mjeanrichard/LoraSensor/Firmware/LoraSensor/README.md

Topic devices/OMG_LILYGO/commands/MQTTtoLORA

{"message":"{\"id\":\"f0f5bdc19400\",\"name\":\"kiwi\",\"test\":false}"}

devices/OMG_LILYGO/LORAtoMQTT/3c84279d2150
