mjeanrichard/LoraSensor/Box/Box.FCStd

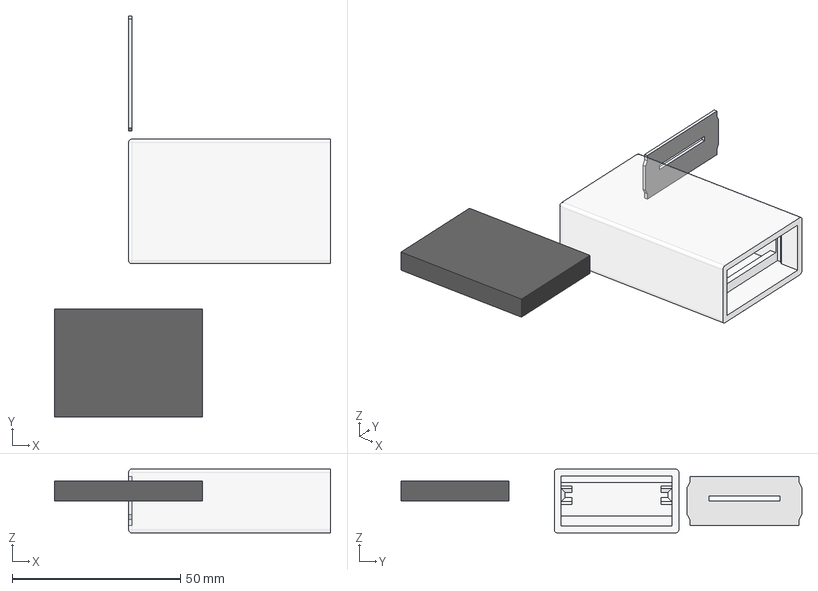
[picture p1: CAD file, 2024-07-07]
Box/Box.FCStd
82.0 x 119.1 x 19.0 mm
BatteryBody
LidBody
