mjeanrichard/LoraSensor/Box/Pcb.FCStd

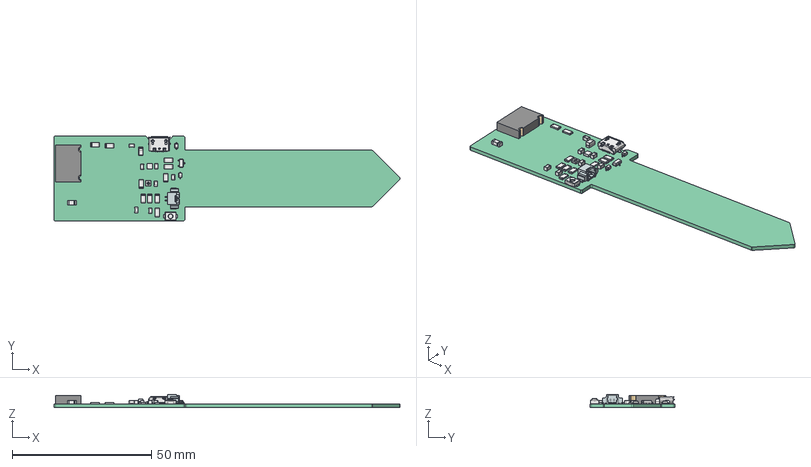
[picture p2: CAD file, 2024-07-07]
Box/Pcb.FCStd
124.2 x 30.5 x 4.69 mm
Pcb_7a2a
R10_R_1206_3216Metric_2f96db2df0e" x 10
C8_C_0805_2012Metric_733a677ac18" x 7
C3_CP_EIA_3216_18_Kemet_A_c737fdafe5b"
U1_WSON_6_1EP_2x2mm_P065mm_EP1x16mm_d4f6cbaf017"
D1_D_SOD_323_4d344dbe9df" x 2
J2_USB_Micro-B_Molex_47346-0001_fa0011b9db4"
J1_532614002wbm000_01_76511110587"
SW1_3x4x2mm - 2 button_fc822de3670"
ANT-433-USP410
ANT-433-USP411
ANT-433-USP412
SHTC1
SHTC002
SHTC003
SHTC004
SHTC005
SHTC006
SHTC007
SHTC008
SHTC009
SHTC010
Q1_SOT_23_b06cfdb17f5"
