mjeanrichard/LoraSensor/Board/LoraSensor/Symbols/ANT-868-USP410.STEP

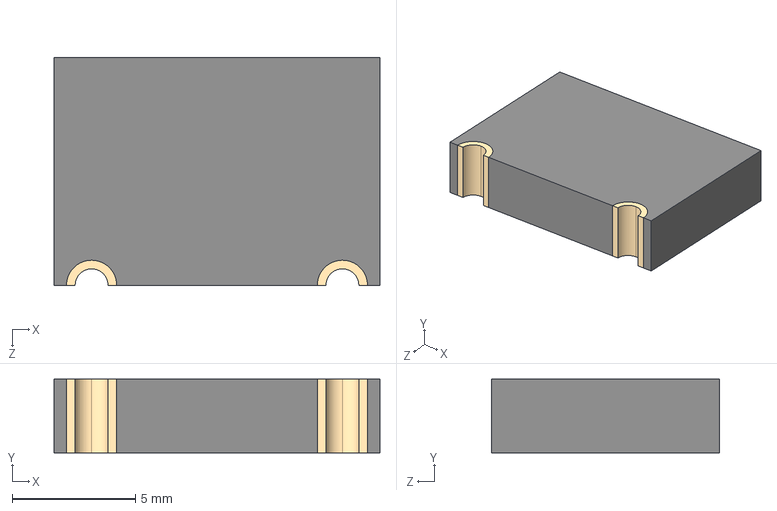
[picture p3: CAD file, 2024-06-06]
Board/LoraSensor/Symbols/ANT-868-USP410.STEP
13.2 x 3.00 x 9.22 mm
