mjeanrichard/LoraSensor/Board/LoraSensor/Symbols/2450AT18A100E_JOT.step

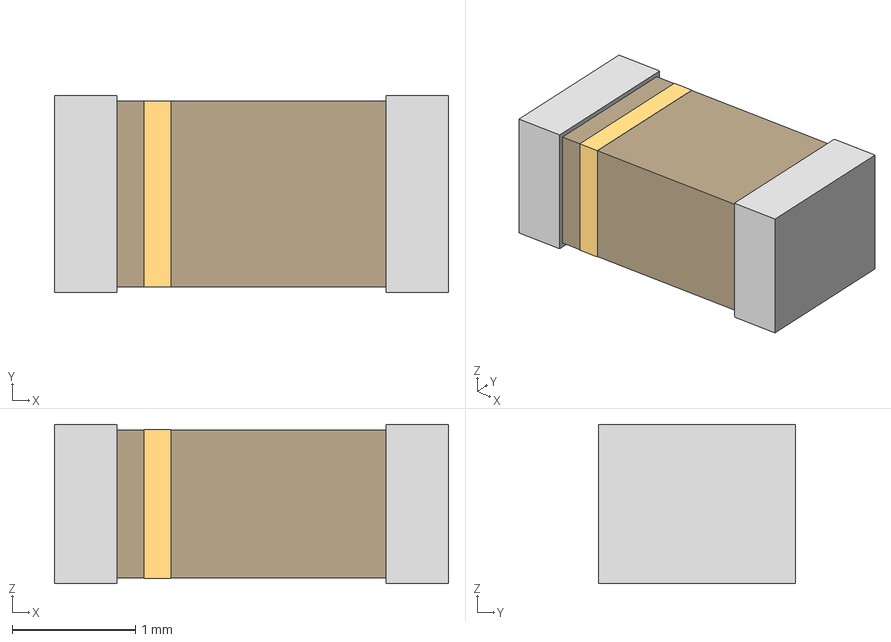
[picture p4: CAD file, 2024-06-06]
Board/LoraSensor/Symbols/2450AT18A100E_JOT.step
3.20 x 1.60 x 1.29 mm
