mjeanrichard/LoraSensor/Box/Box-Body.step

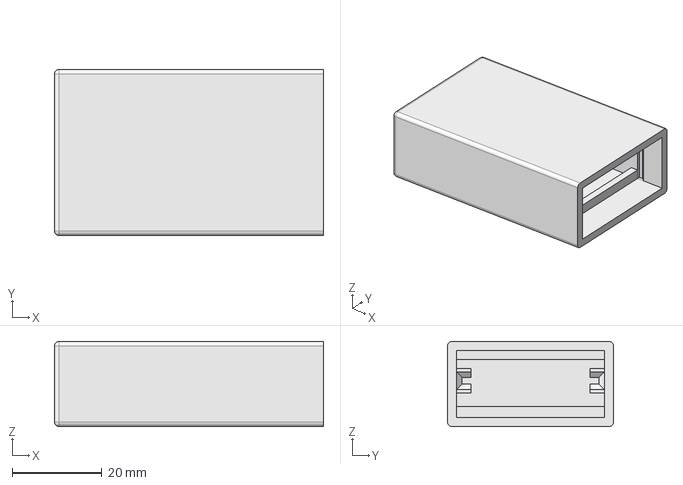
[picture p5: CAD file, 2024-07-07]
Box/Box-Body.step
60.0 x 37.0 x 19.0 mm
