mjeanrichard/LoraSensor/Board/LoraSensor/Symbols/HT_CD_SHTC3_STEP_File_V1_D1.STEP

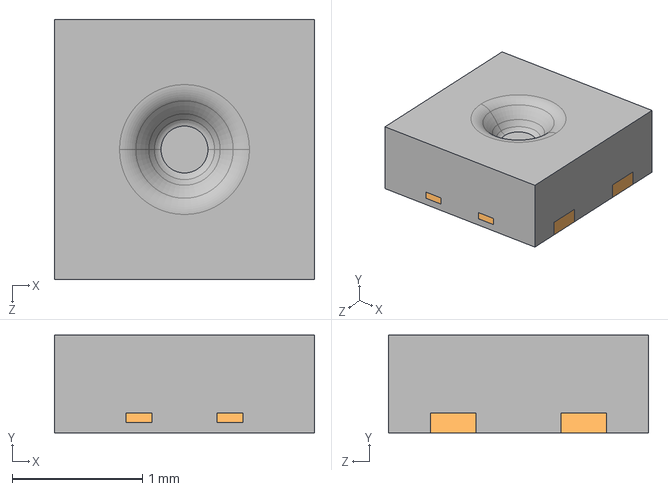
[picture p6: CAD file, 2024-06-06]
Board/LoraSensor/Symbols/HT_CD_SHTC3_STEP_File_V1_D1.STEP
2.00 x 0.75 x 2.00 mm
