mjeanrichard/LoraSensor/Board/LoraSensor/Symbols/532614002.stp

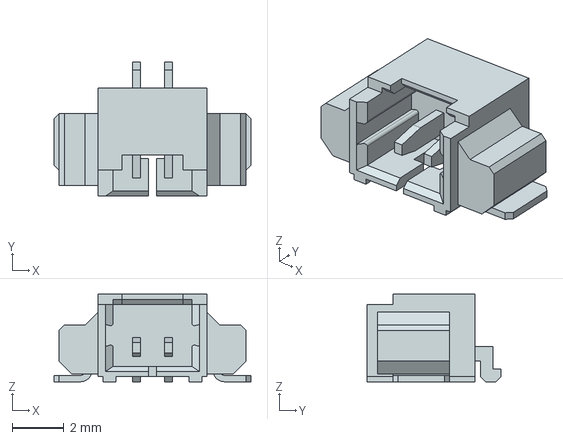
[picture p7: CAD file, 2024-06-06]
Board/LoraSensor/Symbols/532614002.stp
7.65 x 5.20 x 3.40 mm
