mjeanrichard/LoraSensor/Board/LoraSensor/Symbols/532614003.stp

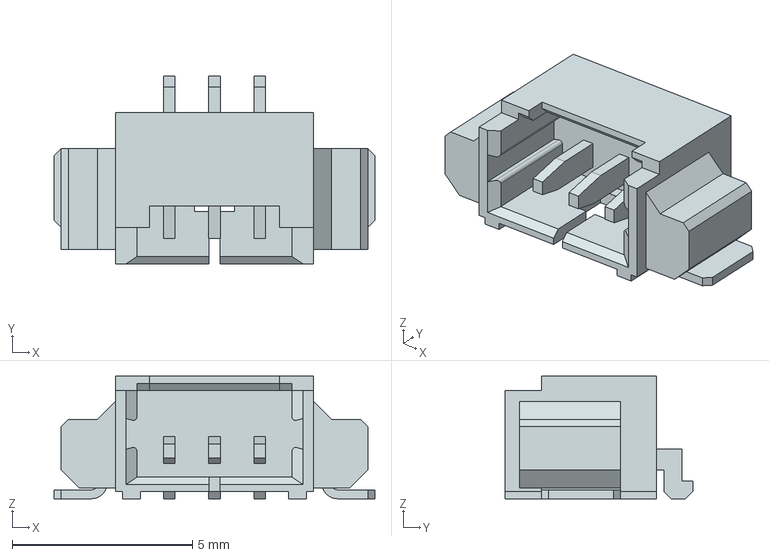
[picture p8: CAD file, 2024-06-06]
Board/LoraSensor/Symbols/532614003.stp
8.90 x 5.20 x 3.40 mm
