mjeanrichard/LoraSensor/(list of files, cad)

Other CAD files:
Box/BoxAssembly.FCStd
