mjeanrichard/LoraSensor/Board/LoraSensor/LoraSensor.kicad_pcb

## KiCad design Board/LoraSensor/LoraSensor.kicad_pcb (2024-07-07)

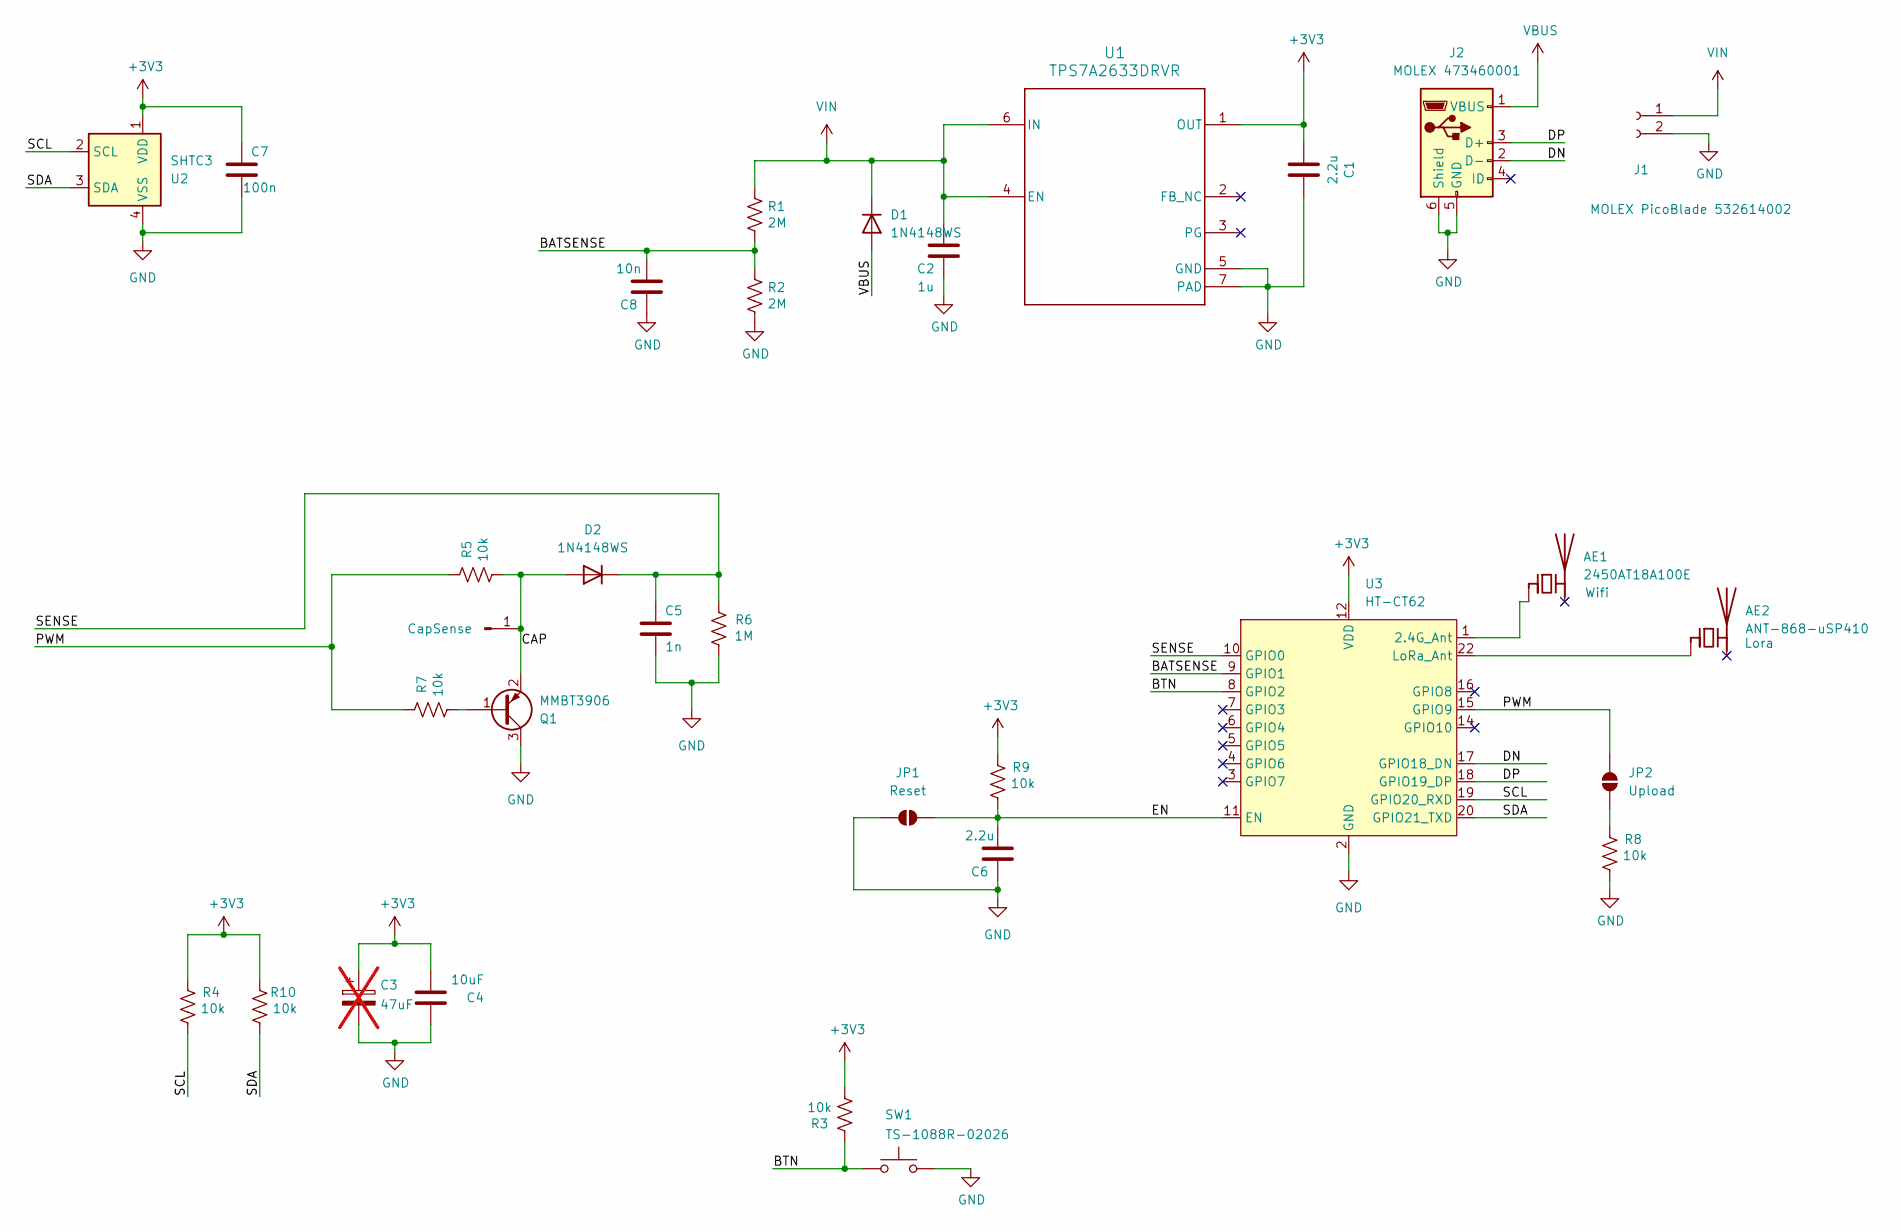
[picture p9: schematic LoraSensor.kicad_sch]

Parts:
AE1: 2450AT18A100E; 2450AT18A100E_JOT
AE2: ANT-868-uSP410
C1, C6: 2.2u; C_0805_2012Metric_Pad1.18x1.45mm_HandSolder
C2: 1u; C_0805_2012Metric_Pad1.18x1.45mm_HandSolder
C3: 47uF; CP_EIA-3216-18_Kemet-A_Pad1.58x1.35mm_HandSolder; not fitted
C4: 10uF; C_0805_2012Metric_Pad1.18x1.45mm_HandSolder
C5: 1n; C_0805_2012Metric_Pad1.18x1.45mm_HandSolder
C7: 100n; C_0805_2012Metric_Pad1.18x1.45mm_HandSolder
C8: 10n; C_0805_2012Metric_Pad1.18x1.45mm_HandSolder
D1, D2: 1N4148WS; D_SOD-323
J1: MOLEX PicoBlade 532614002; 532614002
J2: MOLEX 473460001; USB_Micro-B_Molex_47346-0001
J4: CapSense
JP1: Reset; SolderJumper-2_P1.3mm_Open_RoundedPad1.0x1.5mm
JP2: Upload; SolderJumper-2_P1.3mm_Open_RoundedPad1.0x1.5mm
Q1: MMBT3906; SOT-23
R1, R2: 2M; R_1206_3216Metric
R3, R4, R5, R7, R8, R9, R10: 10k; R_1206_3216Metric
R6: 1M; R_1206_3216Metric
SW1: TS-1088R-02026; smd-tactile
U1: TPS7A2633DRVR; TI_WSON-6-1EP_2x2mm_P0.65mm_EP1x1.6mm
U2: SHTC3; Sensirion_DFN-4-1EP_2x2mm_P1mm_EP0.7x1.6mm
U3: HT-CT62; Heltec_HT-CT62

Connections:
+3V3: C1.2, C3.1, C4.2, C7.1, R3.2, R4.2, R9.2, R10.2, U1.1 (OUT), U2.1 (VDD), U3.12 (VDD)
/BATSENSE: C8.2, R1.2, R2.2, U3.9 (GPIO1)
/BTN: R3.1, SW1.1, U3.8 (GPIO2)
/CAP: D2.2 (A), J4.1, Q1.2 (E), R5.2
/DN: J2.2 (D-), U3.17 (GPIO18_DN)
/DP: J2.3 (D+), U3.18 (GPIO19_DP)
/EN: C6.2, JP1.2 (B), R9.1, U3.11 (EN)
/PWM: JP2.2 (B), R5.1, R7.1, U3.15 (GPIO9)
/SCL: R4.1, U2.2 (SCL), U3.19 (GPIO20_RXD)
/SDA: R10.1, U2.3 (SDA), U3.20 (GPIO21_TXD)
/SENSE: C5.1, D2.1 (K), R6.1, U3.10 (GPIO0)
GND: C1.1, C2.1, C3.2, C4.1, C5.2, C6.1, C7.2, C8.1, J1.2, J2.5 (GND), J2.6 (Shield), JP1.1 (A), Q1.3 (C), R2.1, R6.2, R8.1, SW1.2, U1.5 (GND), U1.7 (PAD), U2.4 (VSS), U3.2 (GND), U3.13 (GND), U3.21 (GND)
unnamed: AE1.1 (FEED), U3.1 (2.4G_Ant)
unnamed: AE2.1 (FEED), U3.22 (LoRa_Ant)
unnamed: JP2.1 (A), R8.2
unnamed: Q1.1 (B), R7.2
VBUS: D1.2 (A), J2.1 (VBUS)
VIN: C2.2, D1.1 (K), J1.1, R1.1, U1.4 (EN), U1.6 (IN)

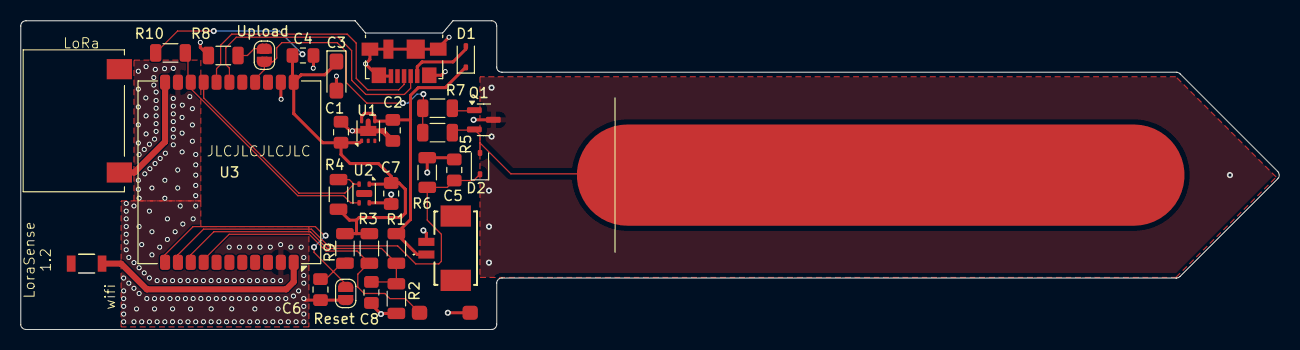
[picture p10: board LoraSensor.kicad_pcb from above]

Board: 2 copper layers, 124.2 x 30.5 mm, 32 parts (0 on the bottom side), 18 nets.
