mjeanrichard/LoraSensor/Firmware/LoraSensor/main/config.h

#pragma once

#include "driver/gpio.h"

#define PIN_SDA GPIO_NUM_21
#define PIN_SCL GPIO_NUM_20
#define PIN_SOIL_SENSE GPIO_NUM_0
#define PIN_SOIL_PWM GPIO_NUM_9
#define PIN_BAT GPIO_NUM_1
#define PIN_BTN GPIO_NUM_2
#define BATTERY_ADC_CHANNEL ADC_CHANNEL_1
#define MOISTURE_ADC_CHANNEL ADC_CHANNEL_0

#define PIN_RADIO_DIO1 GPIO_NUM_3
#define PIN_RADIO_BUSY GPIO_NUM_4
#define PIN_RADIO_RST GPIO_NUM_5
#define PIN_RADIO_MISO GPIO_NUM_6
#define PIN_RADIO_MOSI GPIO_NUM_7
#define PIN_RADIO_NSS GPIO_NUM_8
#define PIN_RADIO_SCK GPIO_NUM_10

#define PWM_FREQ 500000
#define NUM_ADC_READS 5

// %s is replaced by the version string (e.g. "1.1")
#define OTA_FIRMWARE_URL_TEMPLATE "https://github.com/mjeanrichard/LoraSensor/releases/download/v%s/LoraSensor.bin"

#define LORA_FREQ_MHZ   868.0
#define LORA_BW_KHZ     125.0
#define LORA_SF         7
#define LORA_CR         5
#define LORA_SYNC_WORD  0x12
#define LORA_PREAMBLE   8
