mjeanrichard/LoraSensor/Firmware/LoraSensor/main/settings.cpp

#include "settings.h"

static const char *TAG = "SETTINGS";
static const char *NVS_NAMESPACE = "settings";

esp_err_t Settings::save()
{
    nvs_handle_t nvs;

    ESP_RETURN_ON_ERROR(nvs_open(NVS_NAMESPACE, NVS_READWRITE, &nvs), TAG, "Could not open nvs in write mode.");
    ESP_RETURN_ON_ERROR(nvs_set_str(nvs, "name", _name.c_str()), TAG, "Could not write name to nvs.");
    ESP_RETURN_ON_ERROR(nvs_set_i8(nvs, "isTest", _isTest), TAG, "Could not write isTest to nvs.");
    ESP_RETURN_ON_ERROR(nvs_set_u16(nvs, "sleep", _sleepSeconds), TAG, "Could not write sleep to nvs.");
    ESP_RETURN_ON_ERROR(nvs_set_u8(nvs, "wait", _waitSeconds), TAG, "Could not write wait to nvs.");
    ESP_RETURN_ON_ERROR(nvs_set_u8(nvs, "pwr", _transmitPower), TAG, "Could not write pwr to nvs.");
    ESP_RETURN_ON_ERROR(nvs_set_u8(nvs, "retx", _retransmits), TAG, "Could not write retx to nvs.");
    ESP_RETURN_ON_ERROR(nvs_set_u16(nvs, "moiDry", _moiDry), TAG, "Could not write moiDry to nvs.");
    ESP_RETURN_ON_ERROR(nvs_set_u16(nvs, "moiWet", _moiWet), TAG, "Could not write moiWet to nvs.");
    ESP_RETURN_ON_ERROR(nvs_set_str(nvs, "ssid", _ssid.c_str()), TAG, "Could not write ssid to nvs.");
    ESP_RETURN_ON_ERROR(nvs_set_str(nvs, "wifiPwd", _wifiPwd.c_str()), TAG, "Could not write wifiPwd to nvs.");
    ESP_RETURN_ON_ERROR(nvs_set_u16(nvs, "v", ++_configVersion), TAG, "Could not write v to nvs.");
    ESP_RETURN_ON_ERROR(nvs_commit(nvs), TAG, "Could not commit nvs.");
    nvs_close(nvs);

    return ESP_OK;
}

esp_err_t Settings::load()
{
    nvs_handle_t nvs;
    esp_err_t ret = nvs_open(NVS_NAMESPACE, NVS_READONLY, &nvs);
    if (ret == ESP_ERR_NVS_NOT_FOUND)
    {
        _name = "Test";
        save();
        ret = nvs_open(NVS_NAMESPACE, NVS_READONLY, &nvs);
        if (ret != ESP_OK)
        {
            ESP_LOGE(TAG, "Could not open NVS in read mode (%i).", ret);
            return ret;
        }
    }
    else if (ret != ESP_OK)
    {
        ESP_LOGE(TAG, "Failed to open NVS settings (%i).", ret);
        return ret;
    }

    esp_err_t err = ESP_OK;
    if (err == ESP_OK) err = readString(nvs, "name", _name);
    if (err == ESP_OK) err = readBool(nvs, "isTest", &_isTest);
    if (err == ESP_OK) err = nvs_get_u16(nvs, "sleep", &_sleepSeconds);
    if (err == ESP_OK) err = nvs_get_u8(nvs, "wait", &_waitSeconds);
    if (err == ESP_OK) err = nvs_get_u8(nvs, "pwr", &_transmitPower);
    if (err == ESP_OK) err = nvs_get_u8(nvs, "retx", &_retransmits);
    if (err == ESP_OK) err = nvs_get_u16(nvs, "v", &_configVersion);

    // optional keys added in later firmware; keep defaults if absent
    uint16_t tmp;
    if (nvs_get_u16(nvs, "moiDry", &tmp) == ESP_OK) _moiDry = tmp;
    if (nvs_get_u16(nvs, "moiWet", &tmp) == ESP_OK) _moiWet = tmp;
    std::string tmpStr;
    if (readString(nvs, "ssid", tmpStr) == ESP_OK) _ssid = tmpStr;
    if (readString(nvs, "wifiPwd", tmpStr) == ESP_OK) _wifiPwd = tmpStr;

    nvs_close(nvs);
    return err;
}

esp_err_t Settings::readString(nvs_handle_t nvs, const char *key, std::string &field)
{
    size_t len = 0;
    ESP_RETURN_ON_ERROR(nvs_get_str(nvs, key, nullptr, &len), TAG, "Could not get length of '%s' from NVS.", key);
    char buffer[len];
    ESP_RETURN_ON_ERROR(nvs_get_str(nvs, key, buffer, &len), TAG, "Could not get value of '%s' from NVS.", key);
    field.assign(buffer);
    return ESP_OK;
}

esp_err_t Settings::readBool(nvs_handle_t nvs, const char *key, bool *value)
{
    int8_t isTest = false;
    RETURN_ON_ERROR(nvs_get_i8(nvs, key, &isTest));
    *value = isTest;
    return ESP_OK;
}
