mjeanrichard/LoraSensor/(commit log)

2024-06-06 Initial Firmware
    [2450AT18A100E_JOT.step, 532614002.stp, 532614003.stp, ANT-868-USP410.STEP, HT_CD_SHTC3_STEP_File_V1_D1.STEP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]
2024-06-20 PCB V1.1
    [Box.FCStd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]
2024-06-26 Version 1.1
    [Box-Body.step, Box.FCStd, LoraSensor.kicad_pcb, LoraSensor.kicad_sch]
2024-07-07 PCB Version 1.2
    [Box-Body.step, Box.FCStd, BoxAssembly.FCStd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]
2026-06-20 fix add firmware version
    [LoraClient.cpp, adc.cpp, adc.h, config.h, main.cpp, settings.cpp, settings.h]
2026-06-22 fix: first wifi implementation
    [partitions.csv]
